HKUST-Intelligent-Racing/2026-RDC-Controller/2026-RDC-Controller-Edge_Cuts.dxf

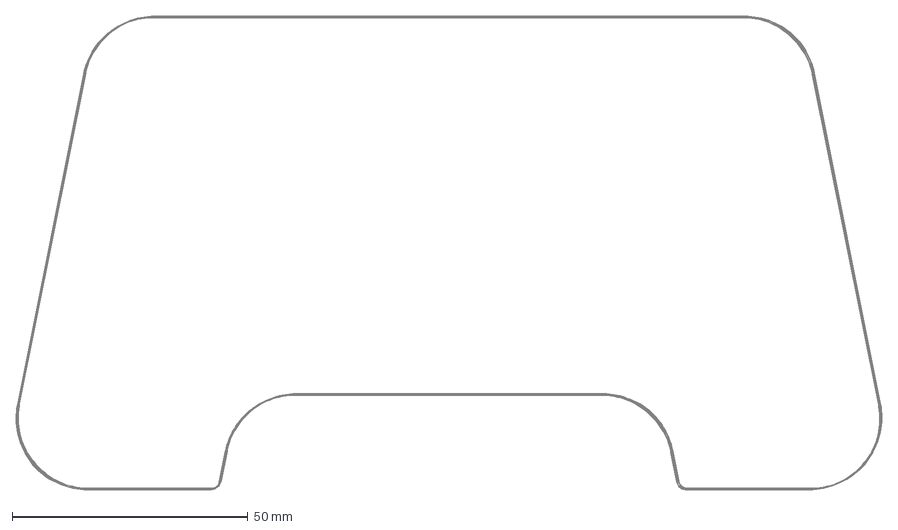
[picture p1: CAD file, 2026-10-25]
2026-RDC-Controller-Edge_Cuts.dxf
183.4 x 100.3 mm
