HKUST-Intelligent-Racing/2026-RDC-Controller/(list of files, cad)

Other CAD files:
2026-RDC-Controller-F_Silkscreen.dxf
