HKUST-Intelligent-Racing/2026-RDC-Controller/2026-RDC-Controller.kicad_sch

## KiCad design 2026-RDC-Controller.kicad_sch (2026-10-25)

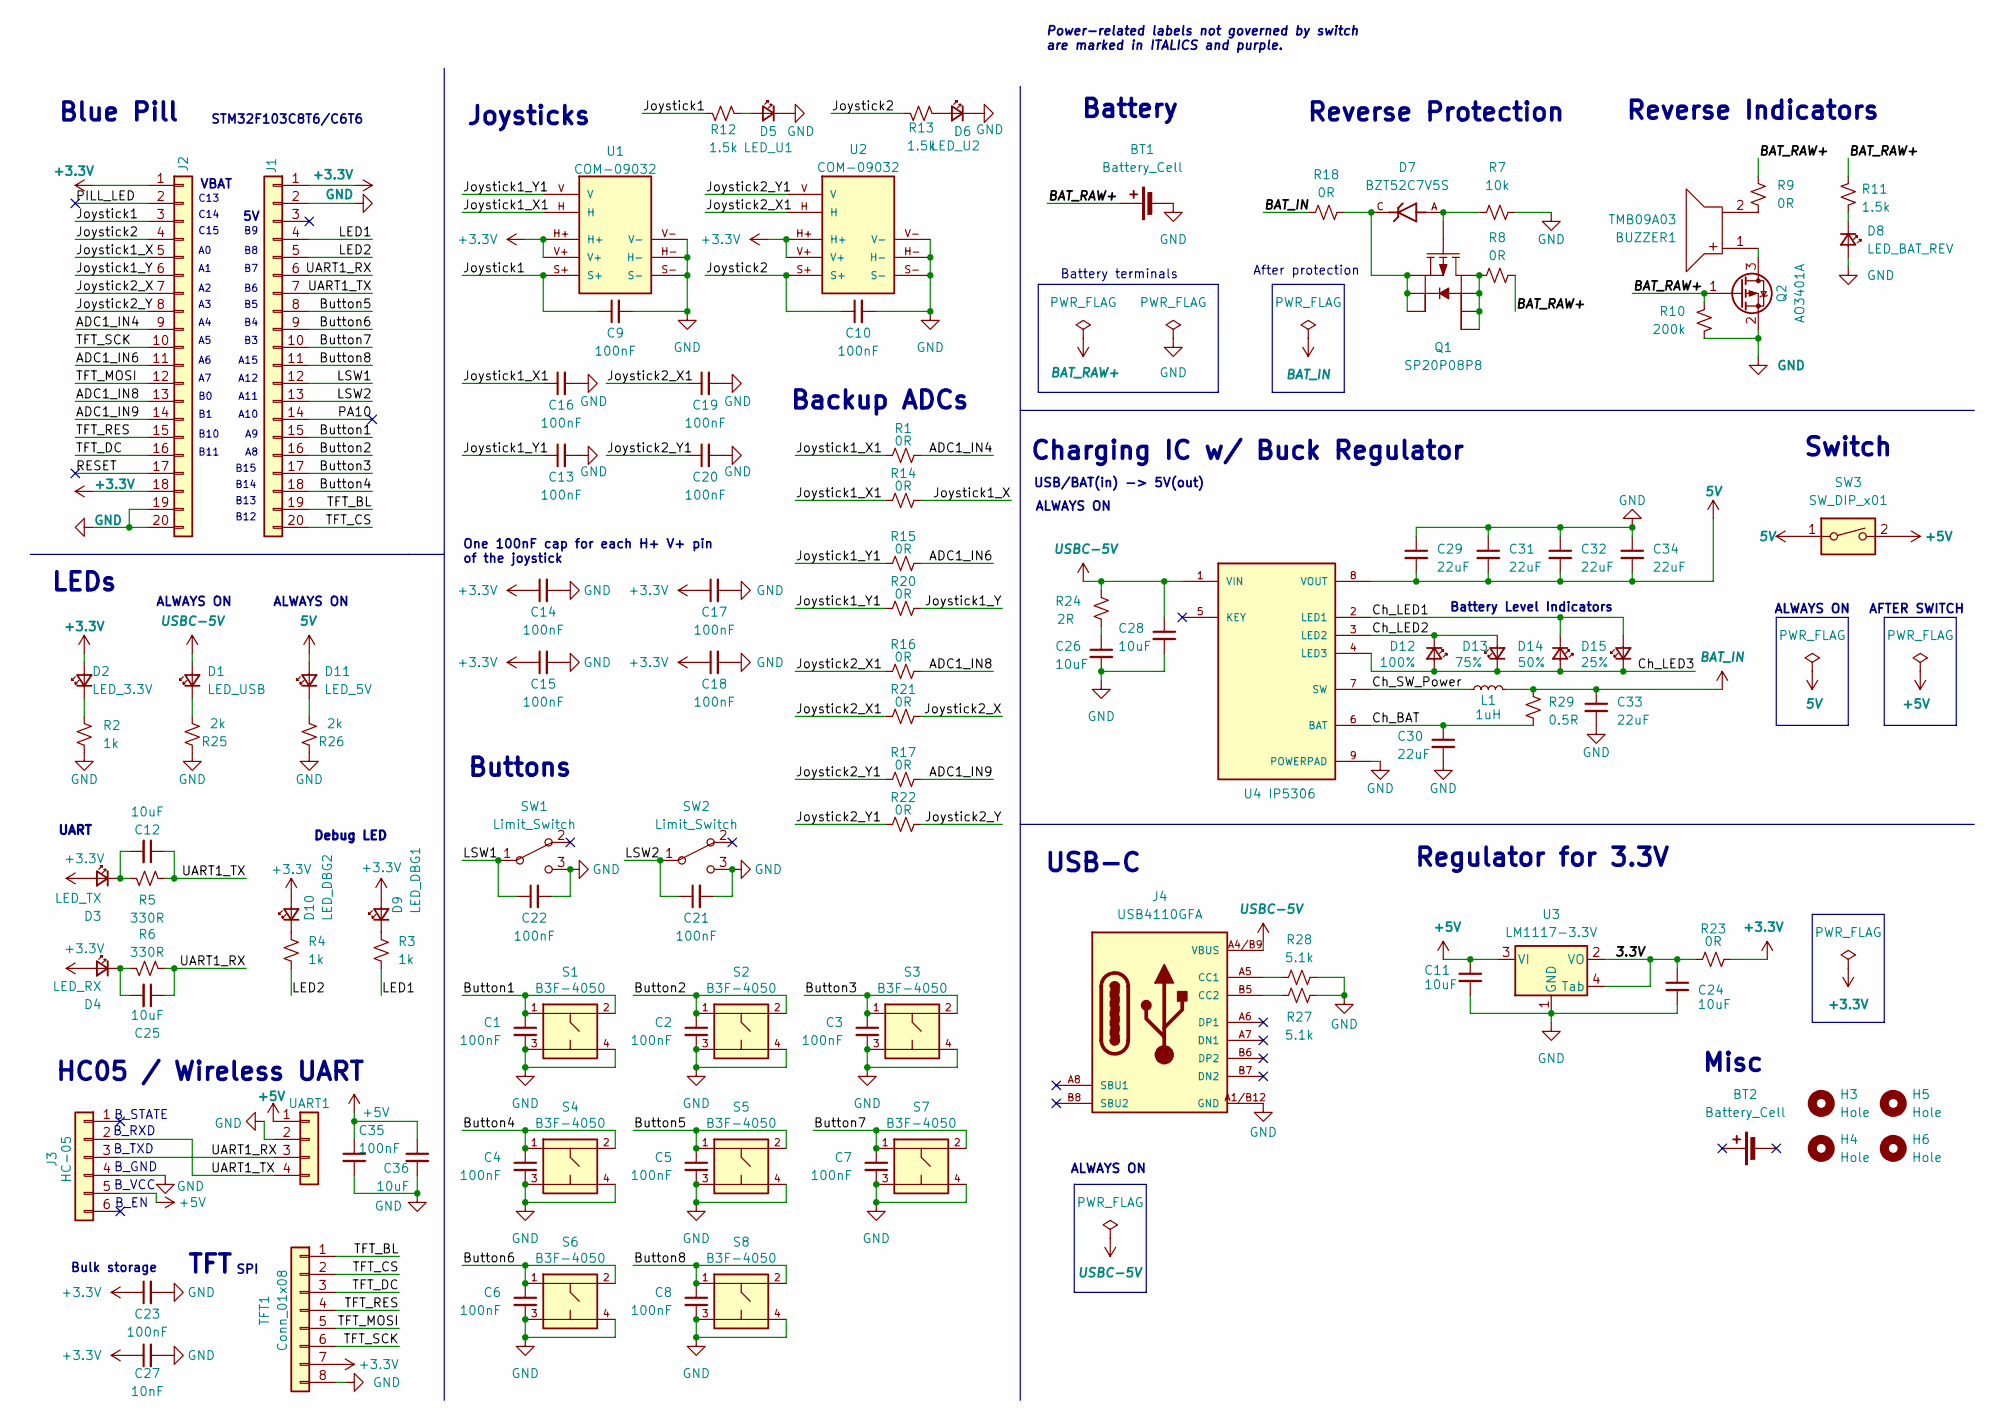
[picture p2: schematic 2026-RDC-Controller.kicad_sch]

Parts:
BT1, BT2: Battery_Cell; BatteryHolder_Keystone_1042_1x18650_EasyEDA
BUZZER1: TMB09A03; BUZ-TH_BD9.0-P5.00-D0.6-L-FD
C1, C2, C3, C4, C5, C6, C7, C8, C9, C10, C13, C14, C15, C16, C17, C18, C19, C20, C21, C22, C23, C35: 100nF; C_0603_1608Metric
C11, C12, C24, C25, C26, C28, C36: 10uF; C_0603_1608Metric
C27: 10nF; C_0603_1608Metric
C29, C30, C31, C32, C33, C34: 22uF; C_0603_1608Metric
D1: LED_USB; LED_0603_1608Metric_Pad1.05x0.95mm_HandSolder
D2: LED_3.3V; LED_0603_1608Metric_Pad1.05x0.95mm_HandSolder
D3: LED_TX; LED_0603_1608Metric_Pad1.05x0.95mm_HandSolder
D4: LED_RX; LED_0603_1608Metric_Pad1.05x0.95mm_HandSolder
D5: LED_U1; LED_0603_1608Metric_Pad1.05x0.95mm_HandSolder
D6: LED_U2; LED_0603_1608Metric_Pad1.05x0.95mm_HandSolder
D7: BZT52C7V5S; DIO_BZT52C7V5S; PARTREV H2212
D8: LED_BAT_REV; LED_0603_1608Metric_Pad1.05x0.95mm_HandSolder
D9: LED_DBG1; LED_0603_1608Metric_Pad1.05x0.95mm_HandSolder
D10: LED_DBG2; LED_0603_1608Metric_Pad1.05x0.95mm_HandSolder
D11: LED_5V; LED_0603_1608Metric_Pad1.05x0.95mm_HandSolder
D12: 100%; LED_0603_1608Metric_Pad1.05x0.95mm_HandSolder
D13: 75%; LED_0603_1608Metric_Pad1.05x0.95mm_HandSolder
D14: 50%; LED_0603_1608Metric_Pad1.05x0.95mm_HandSolder
D15: 25%; LED_0603_1608Metric_Pad1.05x0.95mm_HandSolder
H3, H4, H5, H6: Hole; MountingHole_3.2mm_M3
J1, J2: Conn_01x20; SAMTEC_TSM-120-02-LM-SV
J3: HC-05; PinSocket_1x06_P2.54mm_Vertical
J4: USB4110GFA; USBC_SMT
L1: 1uH; L_Changjiang_FXL0420
Q1: SP20P08P8; SOIC-8_L4.9-W3.9-P1.27-LS6.0-BL
Q2: AO3401A; SOT-23
R1, R8, R9, R14, R15, R16, R17, R18, R20, R21, R22, R23: 0R; R_0603_1608Metric
R2, R3, R4: 1k; R_0603_1608Metric
R5, R6: 330R; R_0603_1608Metric
R7: 10k; R_0603_1608Metric
R10: 200k; R_0603_1608Metric
R11, R12, R13: 1.5k; R_0603_1608Metric
R24: 2R; R_0603_1608Metric
R25, R26: 2k; R_0603_1608Metric
R27, R28: 5.1k; R_0603_1608Metric
R29: 0.5R; R_0603_1608Metric
S1, S2, S3, S4, S5, S6, S7, S8: B3F-4050; B3F4050
SW1: Limit_Switch; RIGHT_SW_Limit_Switch_132
SW2: Limit_Switch; LEFT_SW_Limit_Switch_132
SW3: SW_DIP_x01; SW_Battery
TFT1: Conn_01x08; PinSocket_1x08_P2.54mm_Vertical
U1, U2: COM-09032; PARTREV N/A
U3: LM1117-3.3V; SOT-223
U4: IP5306; SOP127P600X165-9N; PARTREV 1.31
UART1: Conn_01x04; PinSocket_1x04_P2.54mm_Vertical

Connections:
3.3V: C24.1, R23.1, U3.2 (VO), U3.4 (Tab)
5V: C29.2, C31.2, C32.2, C34.2, D11.2 (A), SW3.1, U4.8 (VOUT)
+3.3V: C14.1, C15.1, C17.1, C18.1, C23.1, C27.1, D2.2 (A), D3.2 (A), D4.2 (A), D9.2 (A), D10.2 (A), J1.1, J2.1, J2.18, R23.2, TFT1.7, U1.H+, U1.V+, U2.H+, U2.V+
+5V: C11.1, C35.1, C36.1, J3.5, SW3.2, U3.3 (VI), UART1.1
ADC1_IN4: J2.9, R1.2
ADC1_IN6: J2.11, R15.2
ADC1_IN8: J2.13, R16.2
ADC1_IN9: J2.14, R17.2
BAT_IN: C33.1, L1.2, R18.1, R29.2
BAT_RAW+: BT1.1 (+), Q2.1 (G), R8.2, R9.2, R10.2, R11.1
Button1: C1.1, J1.15, S1.1, S1.2
Button2: C2.1, J1.16, S2.1, S2.2
Button3: C3.1, J1.17, S3.1, S3.2
Button4: C4.1, J1.18, S4.1, S4.2
Button5: C5.1, J1.8, S5.1, S5.2
Button6: C6.1, J1.9, S6.1, S6.2
Button7: C7.1, J1.10, S7.1, S7.2
Button8: C8.1, J1.11, S8.1, S8.2
Ch_BAT: C30.1, R29.1, U4.6 (BAT)
Ch_LED1: D14.1 (K), D15.2 (A), U4.2 (LED1)
Ch_LED2: D12.1 (K), D13.2 (A), U4.3 (LED2)
Ch_LED3: D12.2 (A), D13.1 (K), D14.2 (A), D15.1 (K), U4.4 (LED3)
Ch_SW_Power: L1.1, U4.7 (SW)
GND: BT1.2 (-), C1.2, C2.2, C3.2, C4.2, C5.2, C6.2, C7.2, C8.2, C9.2, C10.2, C11.2, C13.2, C14.2, C15.2, C16.2, C17.2, C18.2, C19.2, C20.2, C21.2, C22.2, C23.2, C24.2, C26.2, C27.2, C28.2, C29.1, C30.2, C31.1, C32.1, C33.2, C34.1, C35.2, C36.2, D5.1 (K), D6.1 (K), D8.2 (A), J1.2, J2.19, J2.20, J3.4, J4.A1/B12 (GND), J4.S2 (GND), J4.S3 (GND), J4.S4 (GND), Q2.2 (S), R2.2, R7.2, R10.1, R25.2, R26.2, R27.2, R28.2, S1.3, S1.4, S2.3, S2.4, S3.3, S3.4, S4.3, S4.4, S5.3, S5.4, S6.3, S6.4, S7.3, S7.4, S8.3, S8.4, SW1.3 (B), SW2.3 (B), TFT1.8, U1.H-, U1.S-, U1.V-, U2.H-, U2.S-, U2.V-, U3.1 (GND), U4.9 (POWERPAD), UART1.2
Joystick1: C9.1, J2.3, R12.2, U1.S+
Joystick1_X: J2.5, R14.2
Joystick1_X1: C16.1, R1.1, R14.1, U1.H
Joystick1_Y: J2.6, R20.2
Joystick1_Y1: C13.1, R15.1, R20.1, U1.V
Joystick2: C10.1, J2.4, R13.2, U2.S+
Joystick2_X: J2.7, R21.2
Joystick2_X1: C19.1, R16.1, R21.1, U2.H
Joystick2_Y: J2.8, R22.2
Joystick2_Y1: C20.1, R17.1, R22.1, U2.V
LED1: J1.4, R3.2
LED2: J1.5, R4.2
LSW1: C22.1, J1.12, SW1.1 (A)
LSW2: C21.1, J1.13, SW2.1 (A)
unnamed: BUZZER1.1, Q2.3 (D)
unnamed: BUZZER1.2, R9.1
unnamed: C12.2, D3.1 (K), R5.2
unnamed: C25.2, D4.1 (K), R6.1
unnamed: C26.1, R24.1
unnamed: D1.1 (K), R25.1
unnamed: D2.1 (K), R2.1
unnamed: D5.2 (A), R12.1
unnamed: D6.2 (A), R13.1
unnamed: D7.A, Q1.4 (G), R7.1
unnamed: D7.C, Q1.1 (S), Q1.2 (S), Q1.3 (S), R18.2
unnamed: D8.1 (K), R11.2
unnamed: D9.1 (K), R3.1
unnamed: D10.1 (K), R4.1
unnamed: D11.1 (K), R26.1
unnamed: J4.A5 (CC1), R28.1
unnamed: J4.B5 (CC2), R27.1
unnamed: Q1.5 (D), Q1.6 (D), Q1.7 (D), Q1.8 (D), R8.1
PA10: J1.14
PILL_LED: J2.2
RESET: J2.17
TFT_BL: J1.19, TFT1.1
TFT_CS: J1.20, TFT1.2
TFT_DC: J2.16, TFT1.3
TFT_MOSI: J2.12, TFT1.5
TFT_RES: J2.15, TFT1.4
TFT_SCK: J2.10, TFT1.6
UART1_RX: C25.1, J1.6, J3.3, R6.2, UART1.3
UART1_TX: C12.1, J1.7, J3.2, R5.1, UART1.4
USBC-5V: C28.1, D1.2 (A), J4.A4/B9 (VBUS), J4.B4/A9 (VBUS), R24.2, U4.1 (VIN)

Notes on the sheet:
Charging IC w/ Buck Regulator
ALWAYS ON
Buttons
A12
A15
Switch
B_STATE
Battery
LEDs
USB-C
Power-related labels not governed by switch are marked in ITALICS and purple.
Blue Pill
A11
B_GND
A10
USB/BAT(in) -> 5V(out)
Battery Level Indicators
HC05 / Wireless UART
Battery terminals
UART
Regulator for 3.3V
After protection
B15
Joysticks
B_EN
B_VCC
C14
B13
Bulk storage
VBAT
C15
Backup ADCs
Reverse Protection
Misc
B11
Debug LED
Reverse Indicators
B14
AFTER SWITCH
B_TXD
B12
C13
SPI
STM32F103C8T6/C6T6
B_RXD
TFT
One 100nF cap for each H+ V+ pin of the joystick
B10
