HKUST-Intelligent-Racing/2026-RDC-Controller/controller.ioc

Mcu.UserName=STM32F103C6Tx
PA0-WKUP.GPIO_Label=Joystick1_X
PA0-WKUP.Signal=ADCx_IN0
PA1.GPIO_Label=Joystick1_Y
PA1.Signal=ADCx_IN1
PA11.GPIO_Label=LimitSwitch2
PA11.Signal=GPIO_Input
PA12.GPIO_Label=LimitSwitch1
PA12.Signal=GPIO_Input
PA13.Signal=SYS_JTMS-SWDIO
PA14.Signal=SYS_JTCK-SWCLK
PA15.GPIO_Label=Button8
PA15.Signal=GPIO_Input
PA2.GPIO_Label=Joystick2_X
PA2.Signal=ADCx_IN2
PA3.GPIO_Label=Joystick2_Y
PA3.Signal=ADCx_IN3
PA4.GPIO_Label=ADC1_IN4
PA4.Signal=ADCx_IN4
PA5.GPIO_Label=TFT_SCK
PA5.Signal=SPI1_SCK
PA6.Signal=ADCx_IN6
PA7.GPIO_Label=TFT_MOSI
PA7.Signal=SPI1_MOSI
PA8.GPIO_Label=Button2
PA8.Signal=GPIO_Input
PA9.GPIO_Label=Button1
PA9.Signal=GPIO_Input
PB0.Signal=ADCx_IN8
PB1.Signal=ADCx_IN9
PB10.GPIO_Label=TFT_RES
PB10.Signal=GPIO_Output
PB11.GPIO_Label=TFT_DC
PB11.Signal=GPIO_Output
PB12.GPIO_Label=TFT_CS
PB12.Signal=GPIO_Output
PB13.GPIO_Label=TFT_BL
PB13.Signal=GPIO_Output
PB14.GPIO_Label=Button4
PB14.Signal=GPIO_Input
PB15.GPIO_Label=Button3
PB15.Signal=GPIO_Input
PB2.GPIO_Label=BOOT1
PB2.Signal=GPIO_Input
PB3.GPIO_Label=Button7
PB3.Signal=GPIO_Input
PB4.GPIO_Label=Button6
PB4.Signal=GPIO_Input
PB5.GPIO_Label=Button5
PB5.Signal=GPIO_Input
PB6.Signal=USART1_TX
PB7.Signal=USART1_RX
PB8.GPIO_Label=LED2
PB8.Signal=GPIO_Output
PB9.GPIO_Label=LED1
PB9.Signal=GPIO_Output
PC13-TAMPER-RTC.GPIO_Label=PILL_LED
PC13-TAMPER-RTC.Signal=GPIO_Output
PC14-OSC32_IN.GPIO_Label=Joystick1_Button
PC14-OSC32_IN.Signal=GPIO_Input
PC15-OSC32_OUT.GPIO_Label=Joystick2_Button
PC15-OSC32_OUT.Signal=GPIO_Input
PD0-OSC_IN.Signal=RCC_OSC_IN
PD1-OSC_OUT.Signal=RCC_OSC_OUT
